Xinyuan-LilyGO/T-Display-P4-Air/firmware/[T-Display-P4-Air][nrf9151][ncs-serial-modem]/README.md

# Firmware Modification Log

## 202607141440
### Changed firmware
- `[T-Display-P4-Air][nrf9151][ncs-serial-modem_v1.0.1]_firmware_202607141440`
### Change content
- 添加 GNSS NMEA 原始数据输出指令

## 202607110924
### Changed firmware
- `[T-Display-P4-Air][nrf9151][ncs-serial-modem_v1.0.1]_firmware_202607110924.hex`
- `mfw_nrf91x1_2.0.4`
### Change content
- 初始版本
