Xinyuan-LilyGO/T-Display-P4-Air/firmware/[T-Display-P4-Air][rf_test]/README.md

# Firmware Modification Log

## 202607111723
### Changed firmware
- `[T-Display-P4-Air][rf_test]_firmware_202607111723`
### Change content
- 初始版本。
