Xinyuan-LilyGO/T-Display-P4-Air/project/T-Display-P4-Air_v1.0(Evaluation Preview)_202610161627.pdf

## C13¹uF/16V

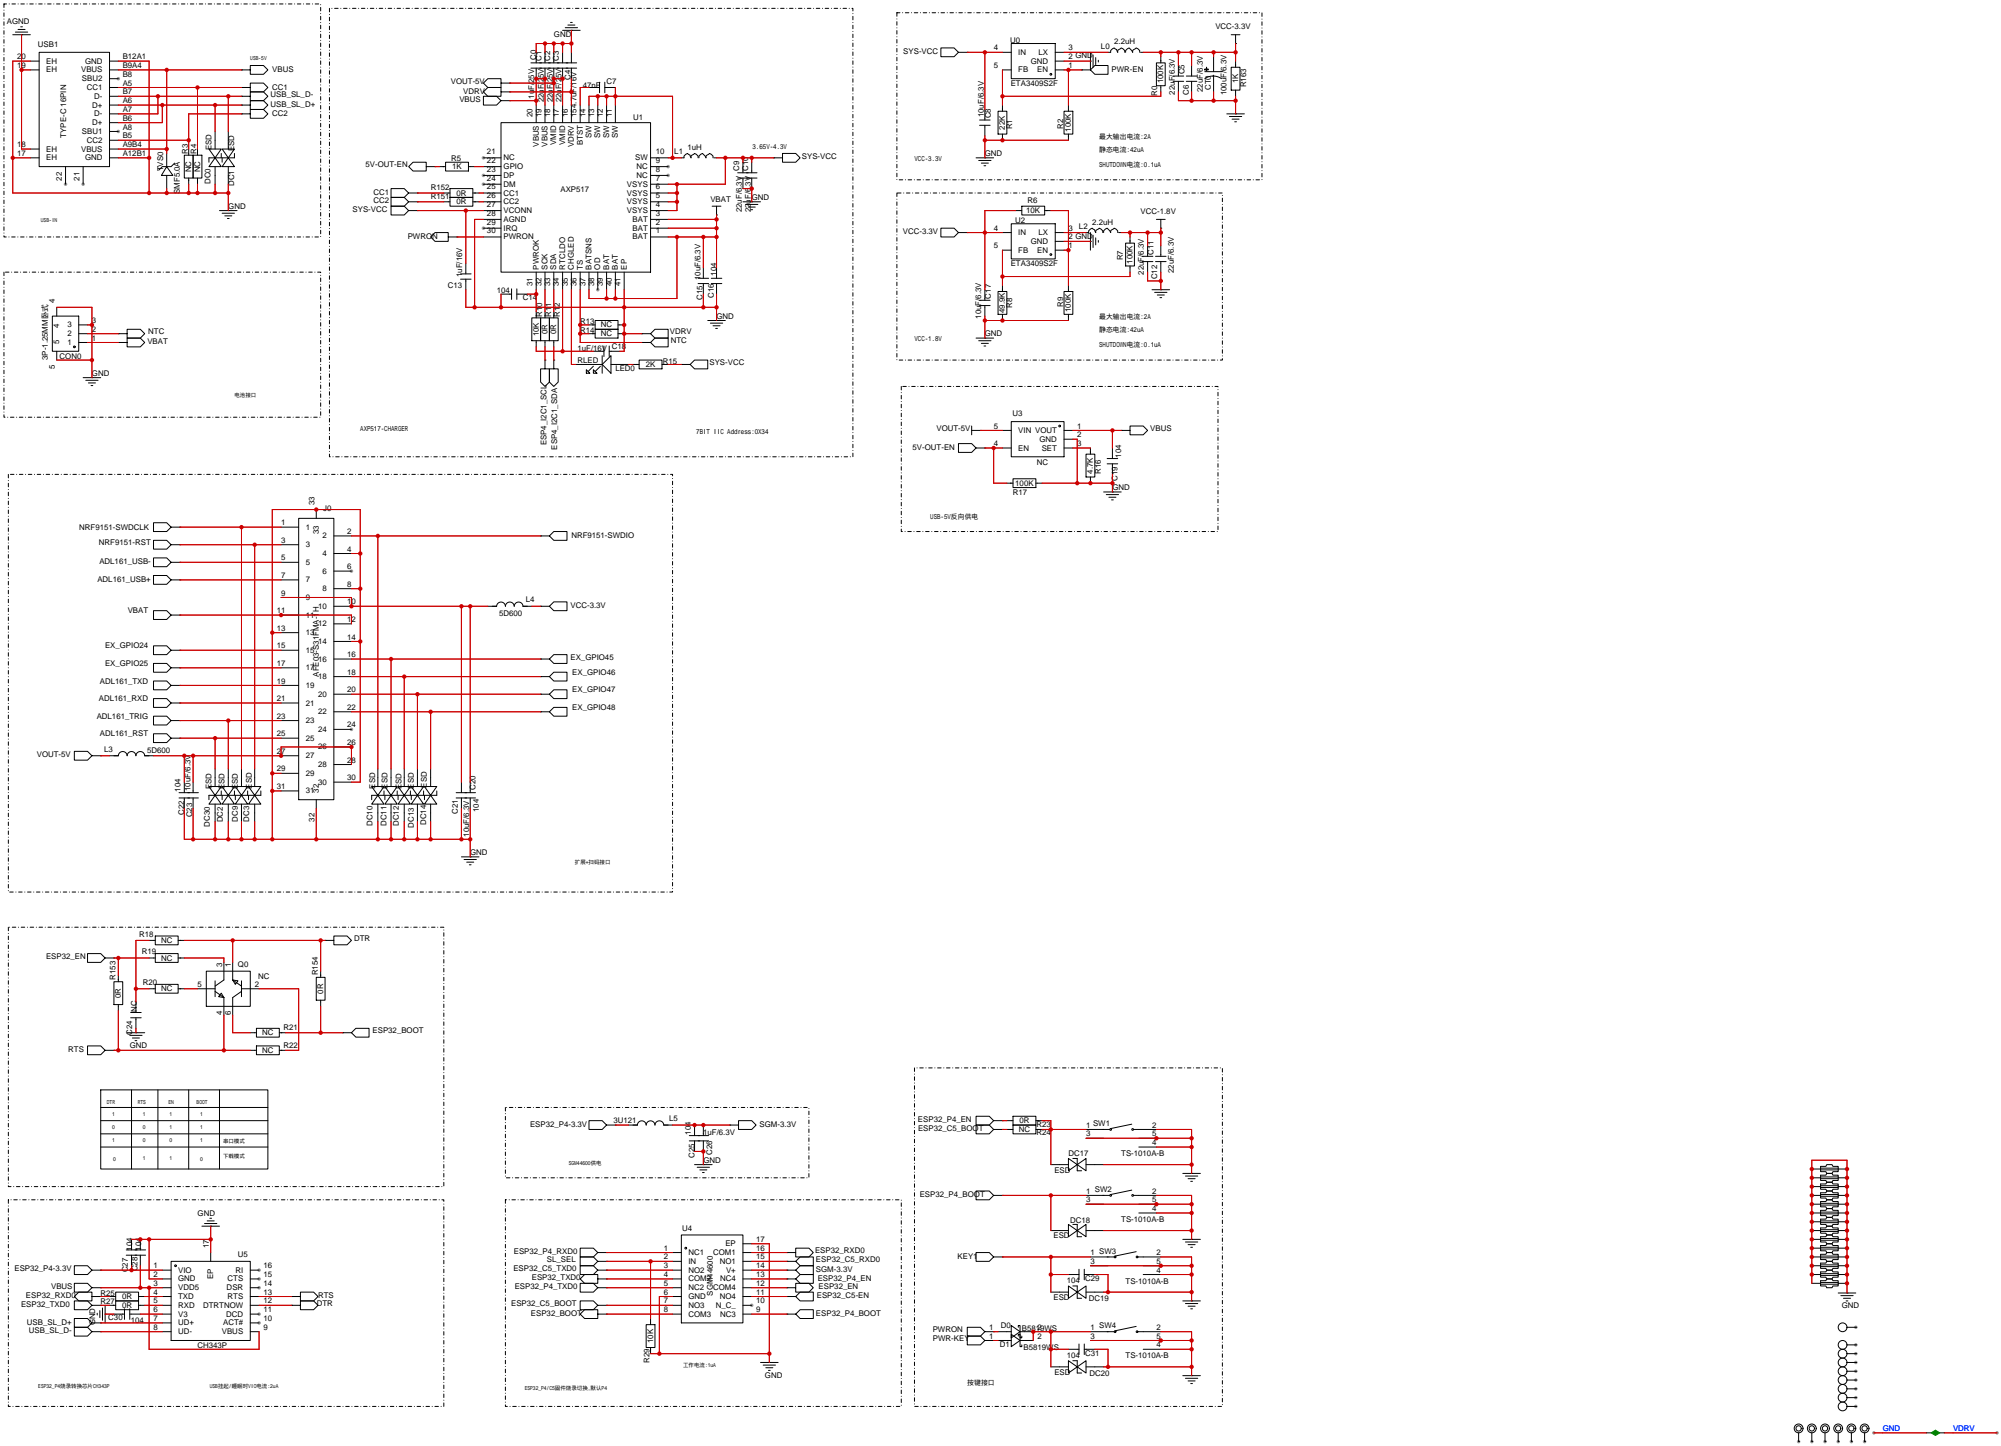
[picture p1: page 1]

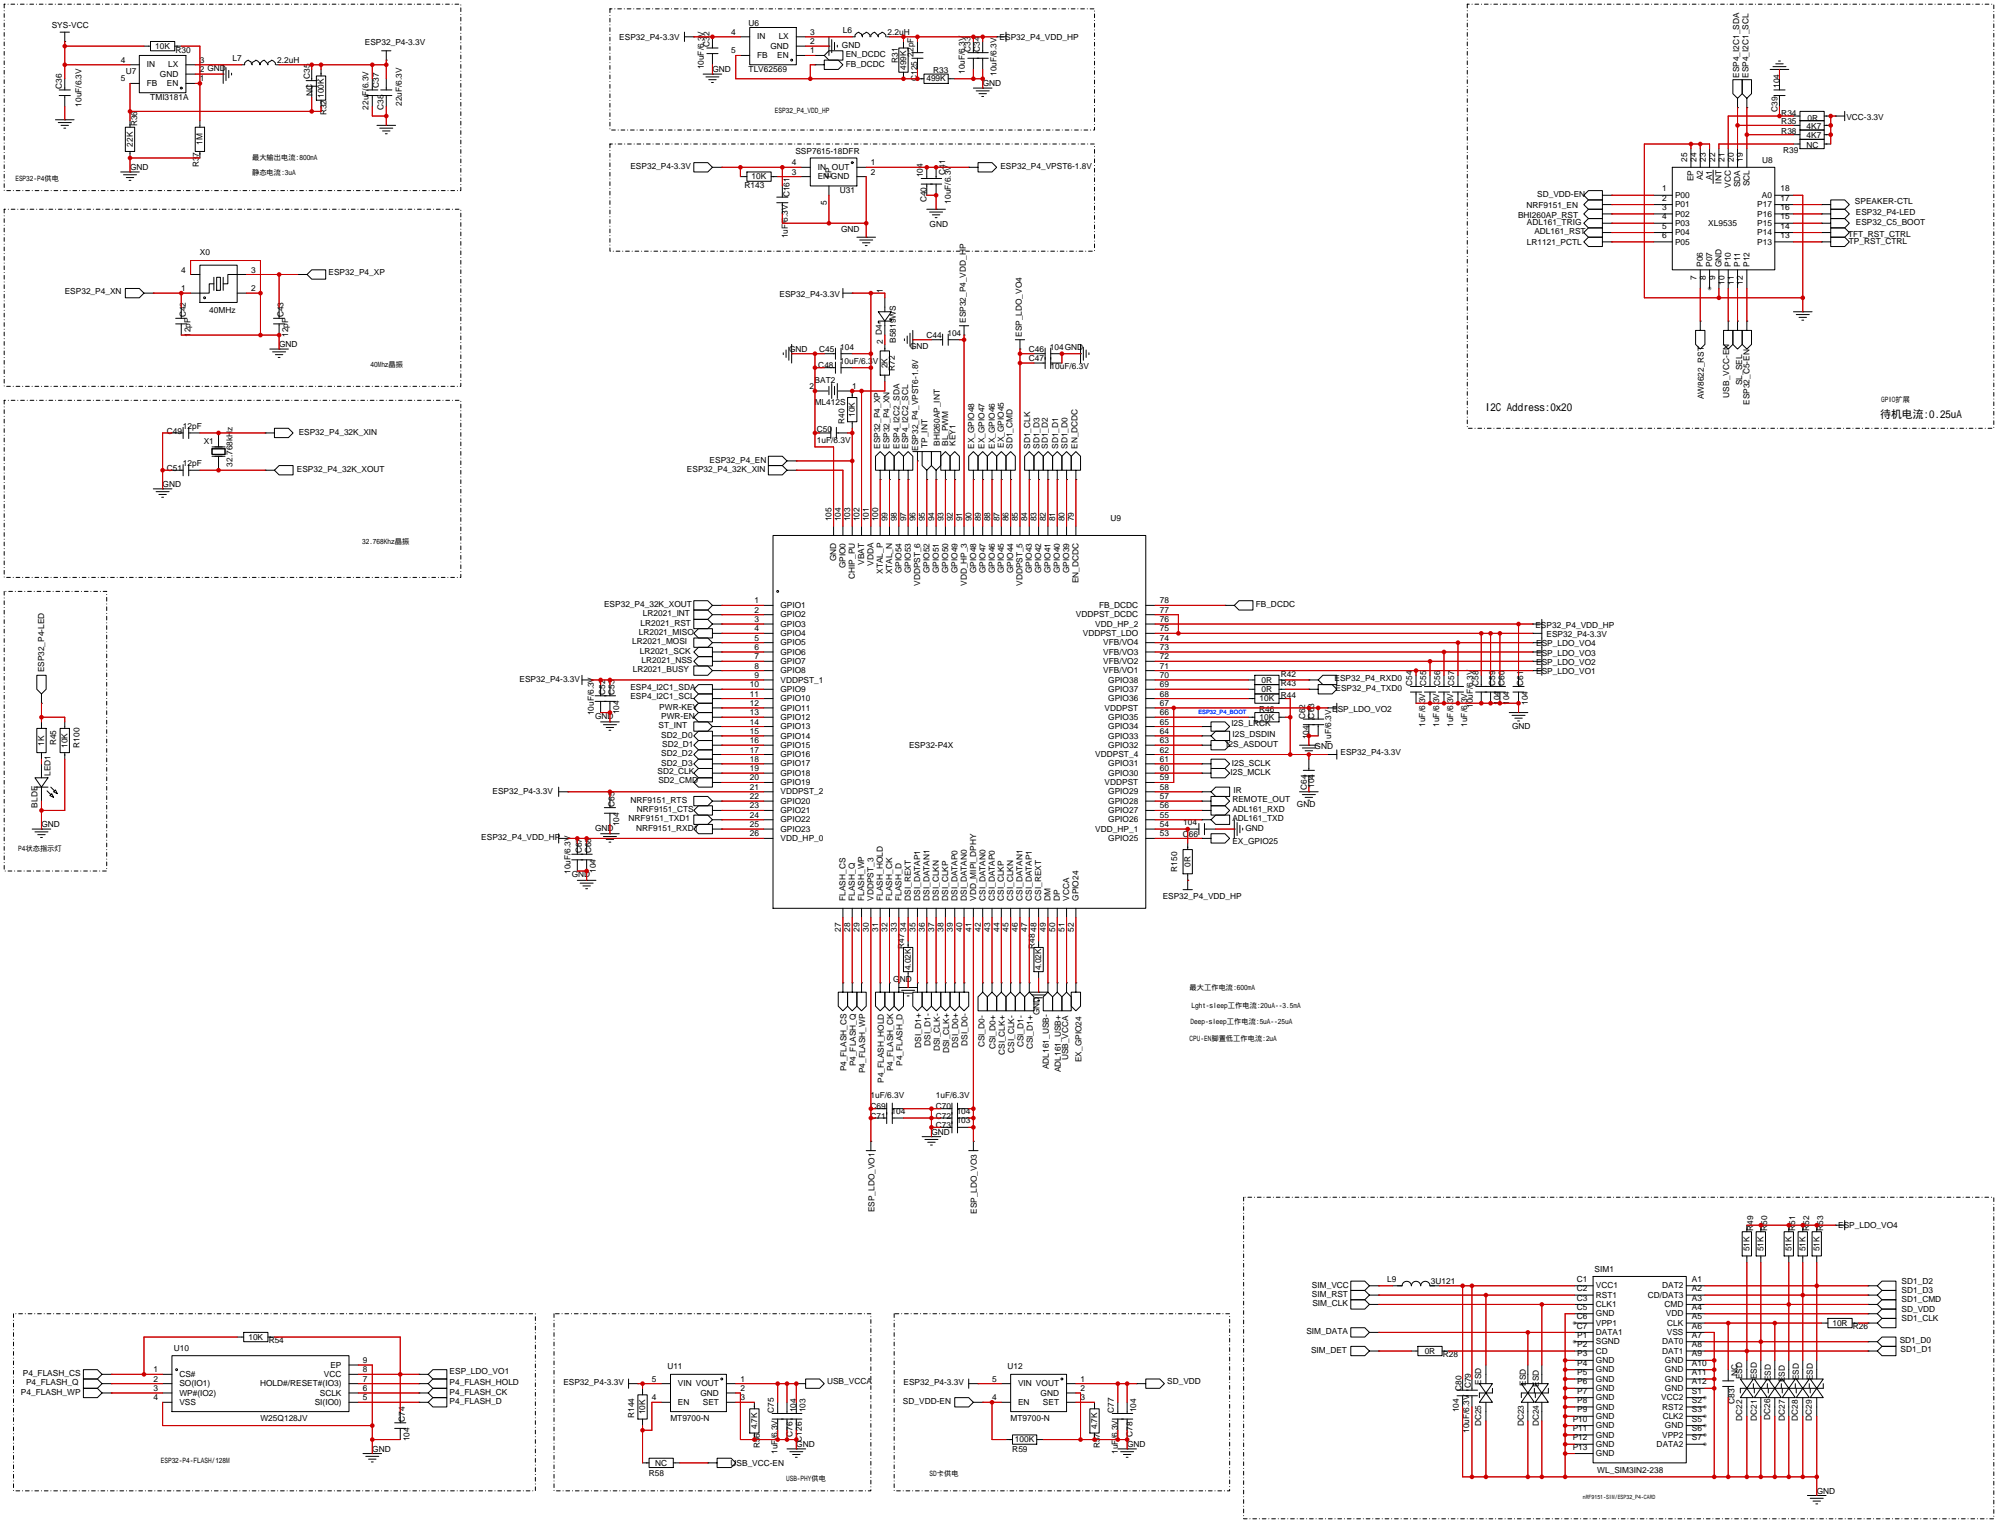
[picture p2: page 2]

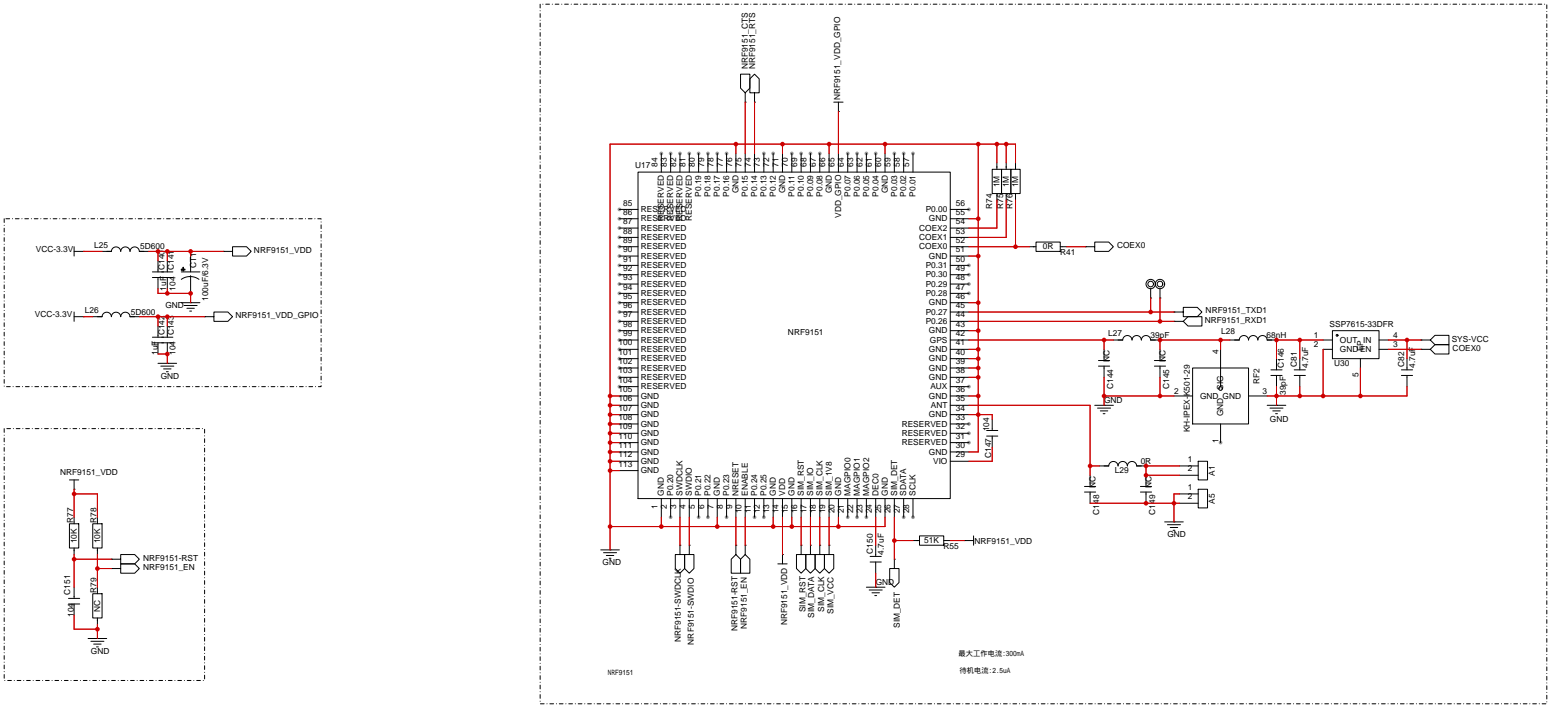
[picture p3: page 3]

L46 | 22uH | 1 D3 | B5819WS 2 C²³⁵ ¹⁰uF/6.3V

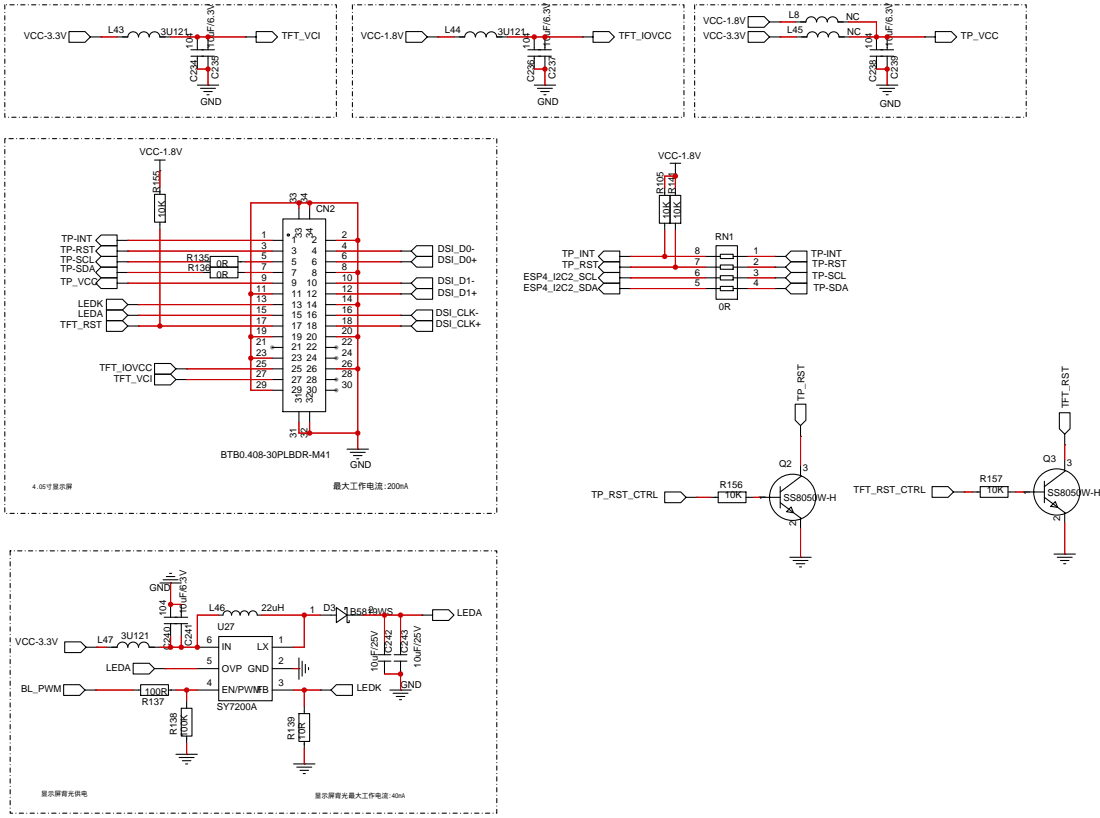
[picture p4: page 4]

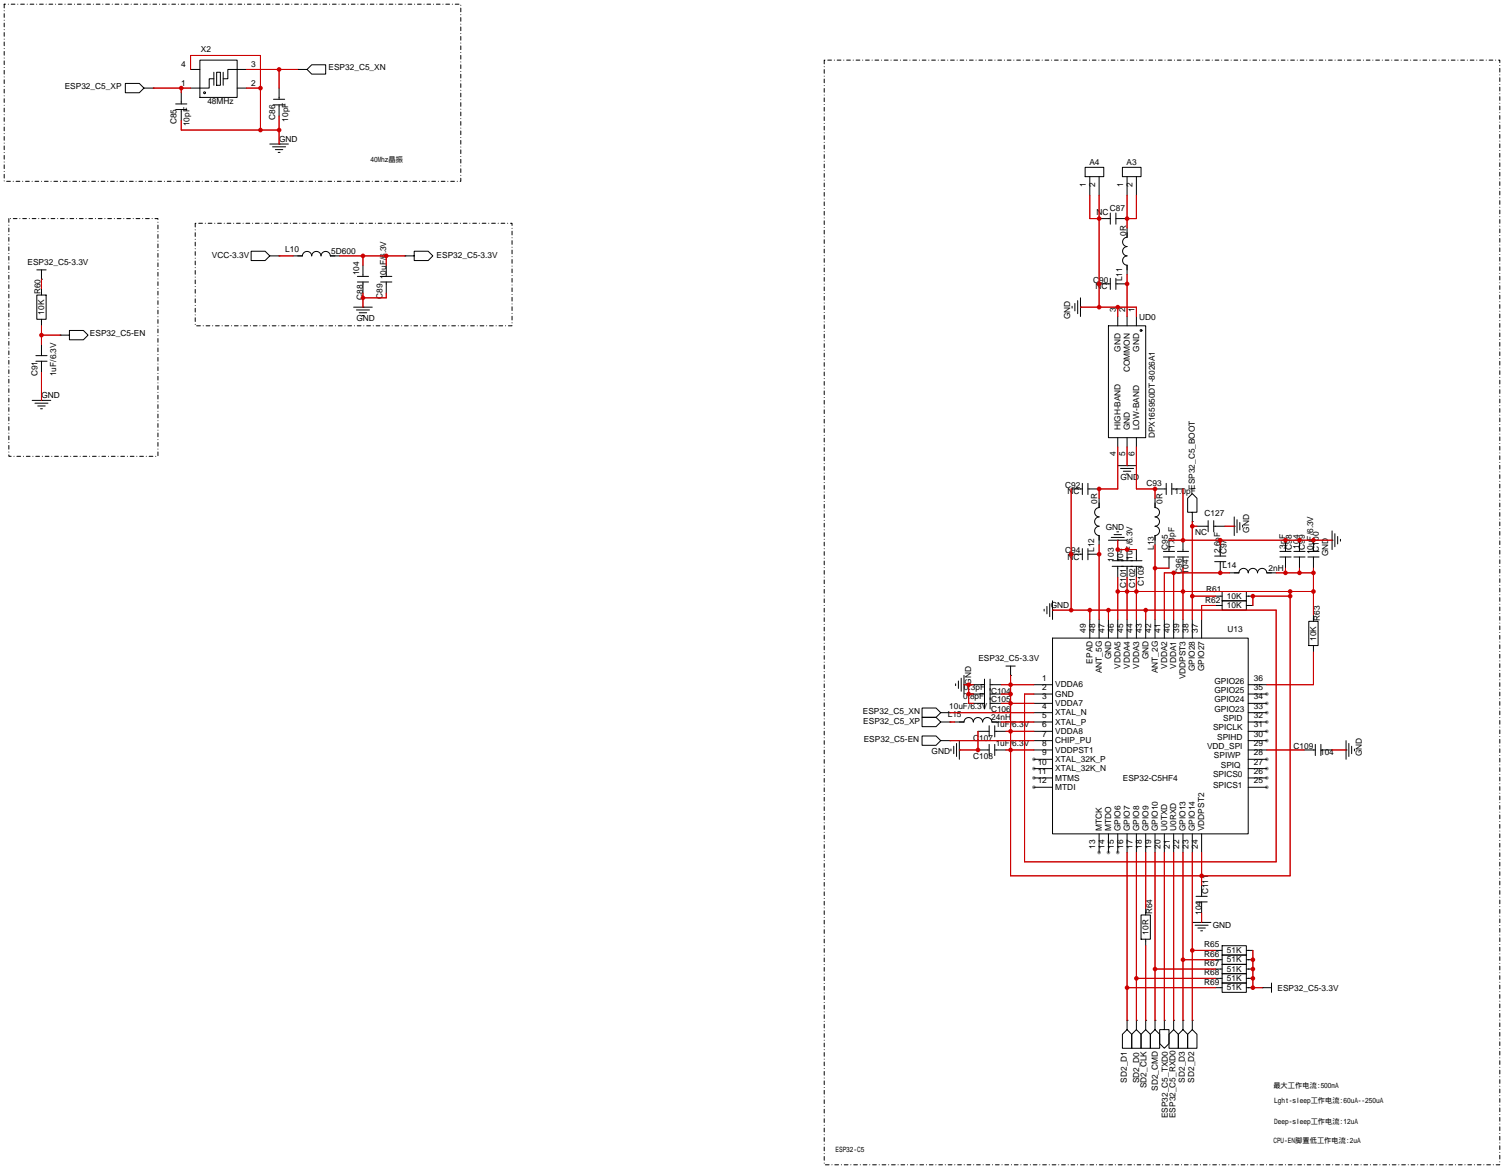
[picture p5: page 5]

GND 1 COMMON 2 GND 3 HIGH-BAND 4 GND 5 LOW-BAND 6

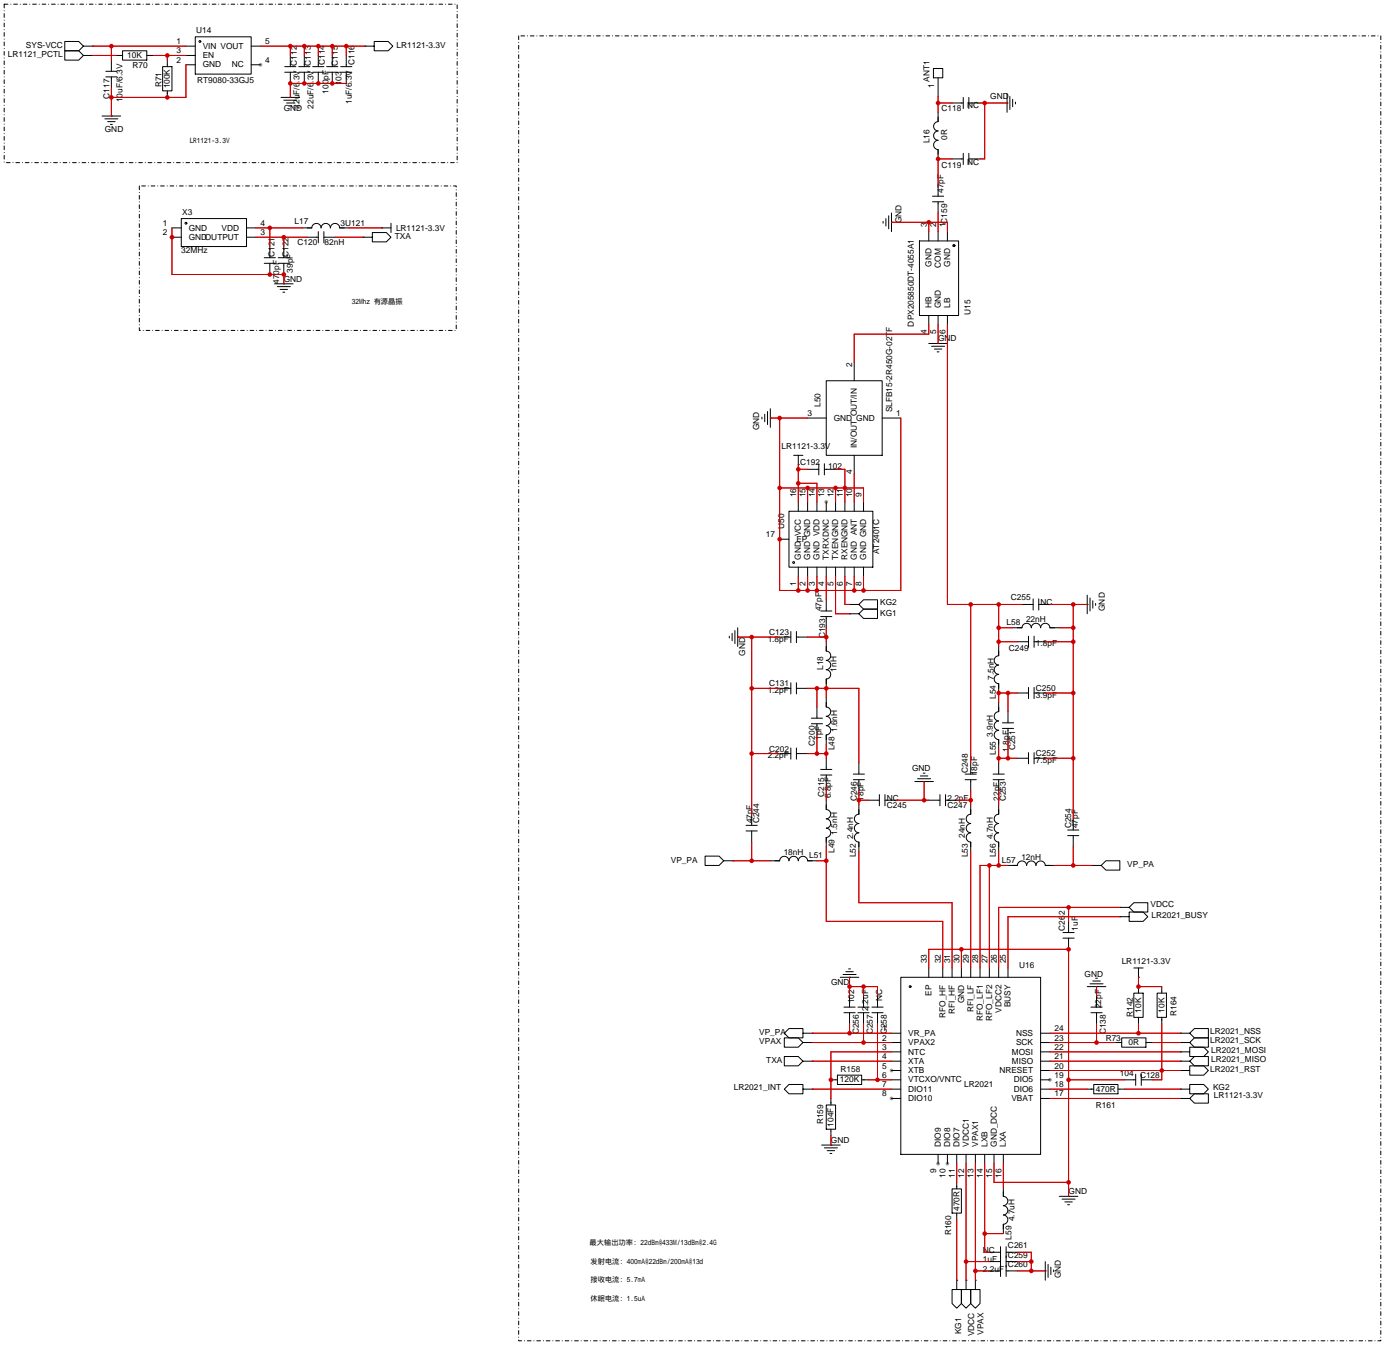
[picture p6: page 6]

9 ANT 10 GND 11 GND 12 DNC 13 VDD 14 GND 15 VCC 16

## 10KC¹⁶⁰

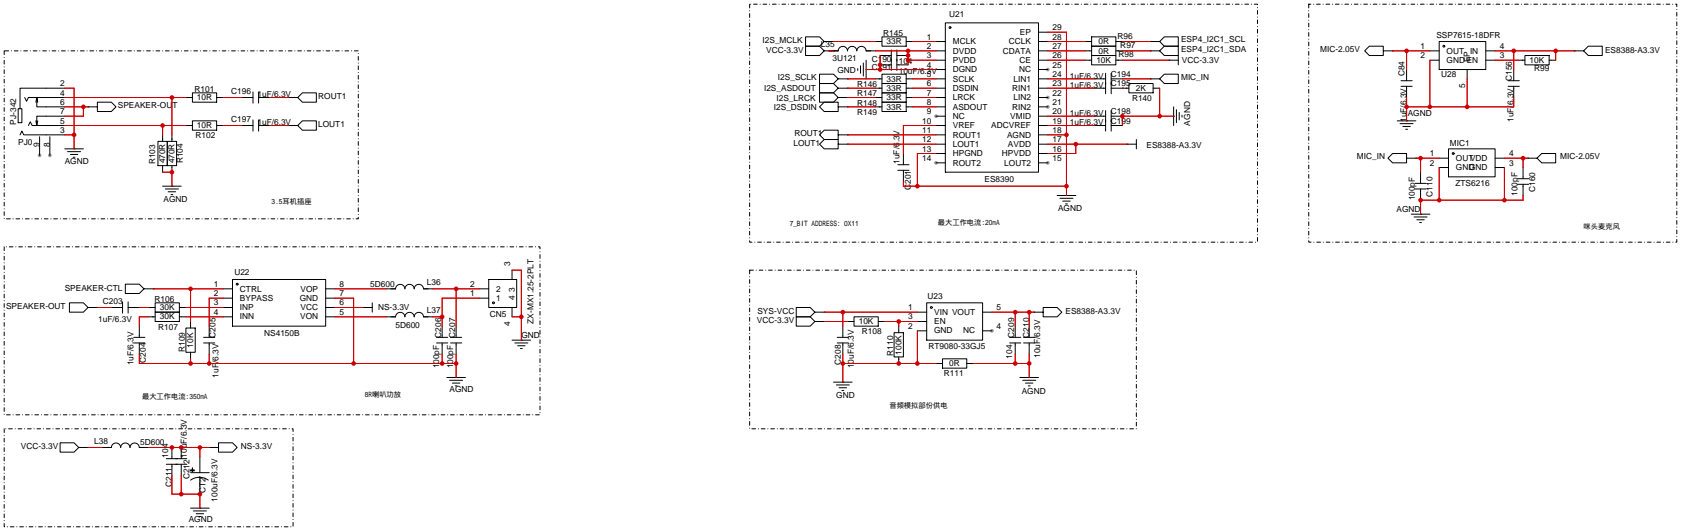
[picture p7: page 7]

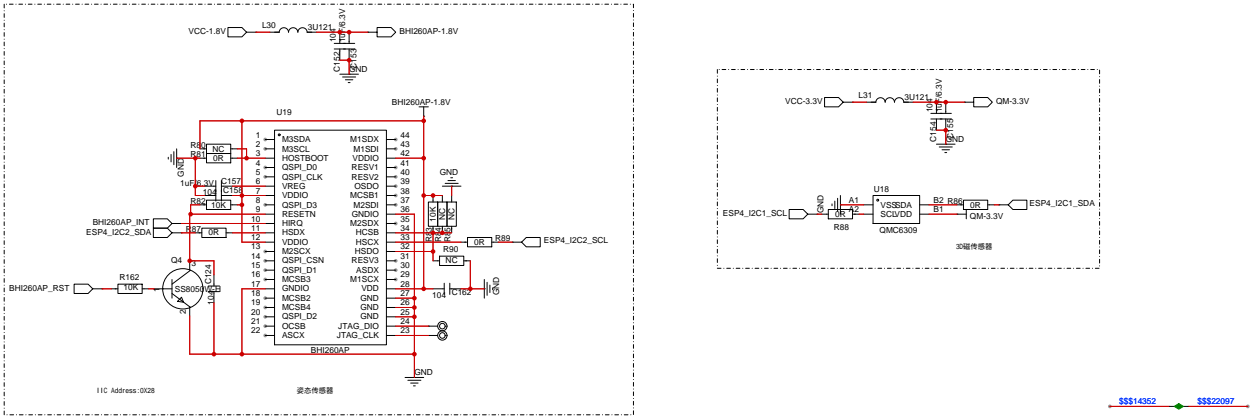
[picture p8: page 8]

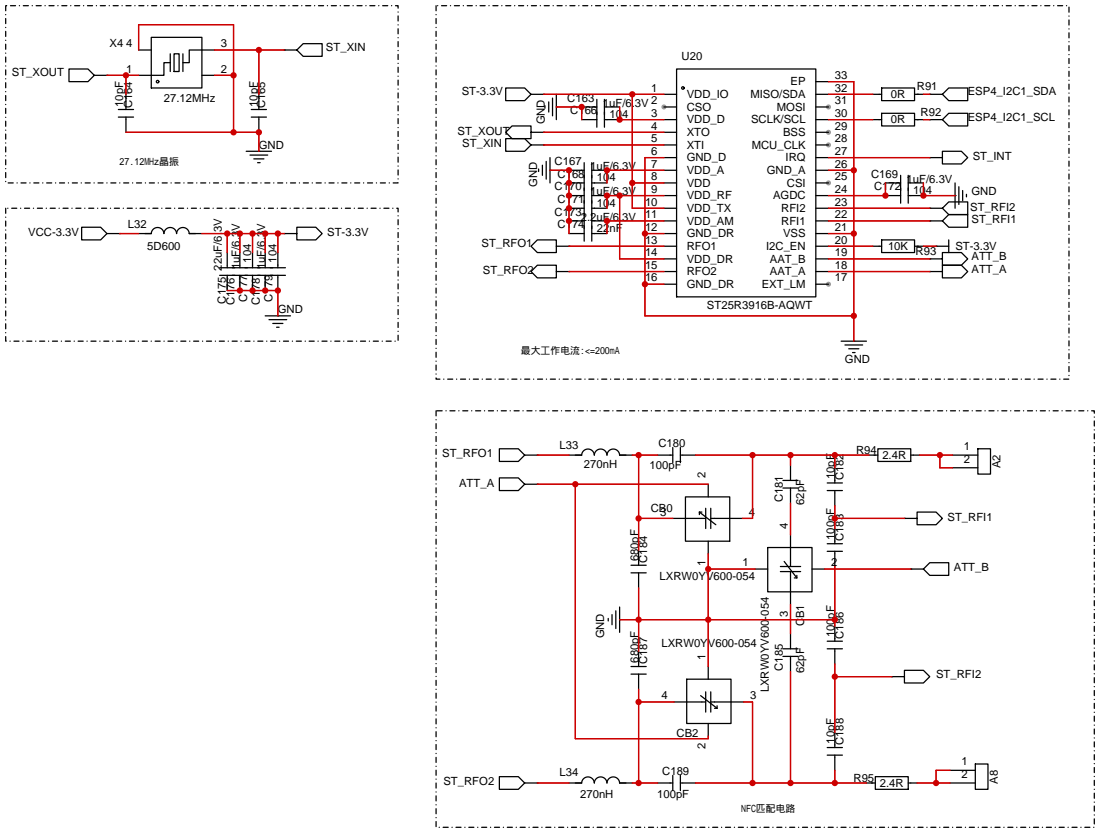
[picture p9: page 9]

C163 | 1uF/6.3V | CSO 2 VDD_D 3
C166 | | 104

VDD_TX 10
GND_DR 12

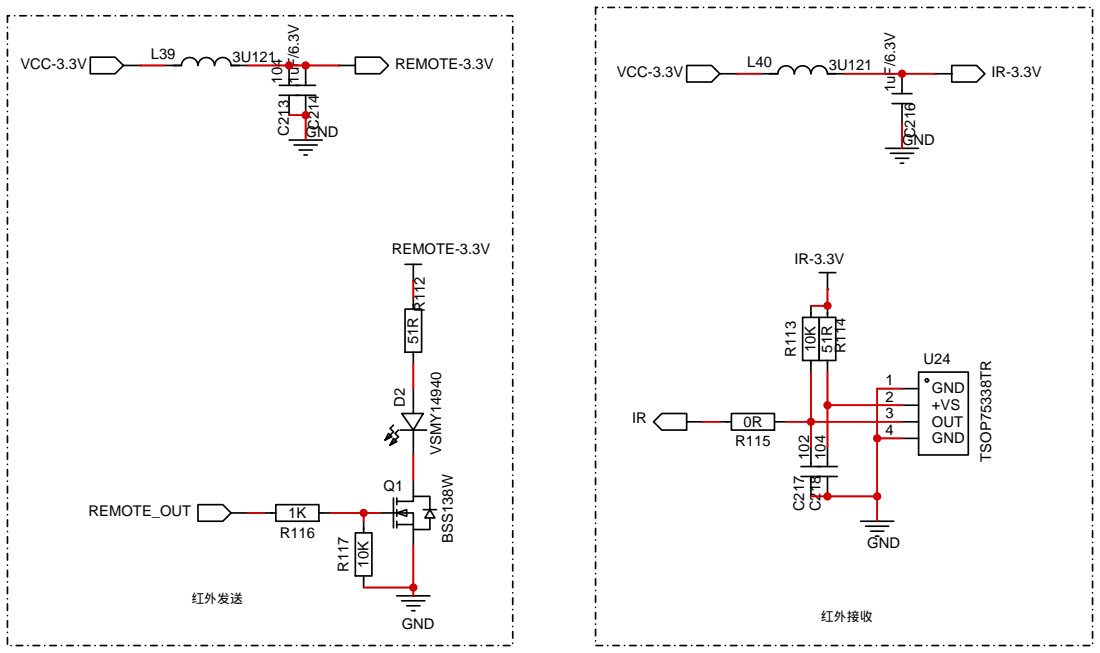
[picture p10: page 10]

# R122 NC R¹²⁵ ⁵¹K

10 | 10 11 | 11 12 | 12 13 | 13 14 | 14 15 | 15 16 | 16 17 | 17 18 | 18 19 | 19 20 | 20 21 | 21 22 | 22 23 | 23 24 | 24

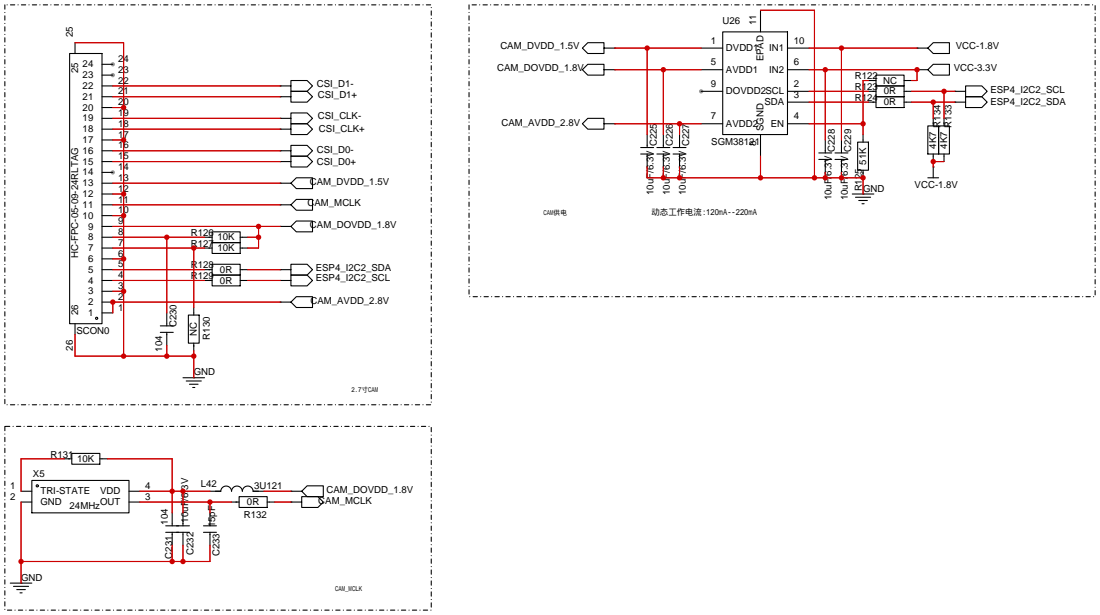
[picture p11: page 11]

SCON0 HC⁻FPC⁻⁰⁵⁻⁰⁹⁻²⁴RLTAG

# AW86224AFCRC²²⁰ ¹⁰uF/6.3V C²¹⁹ ¹⁰⁴

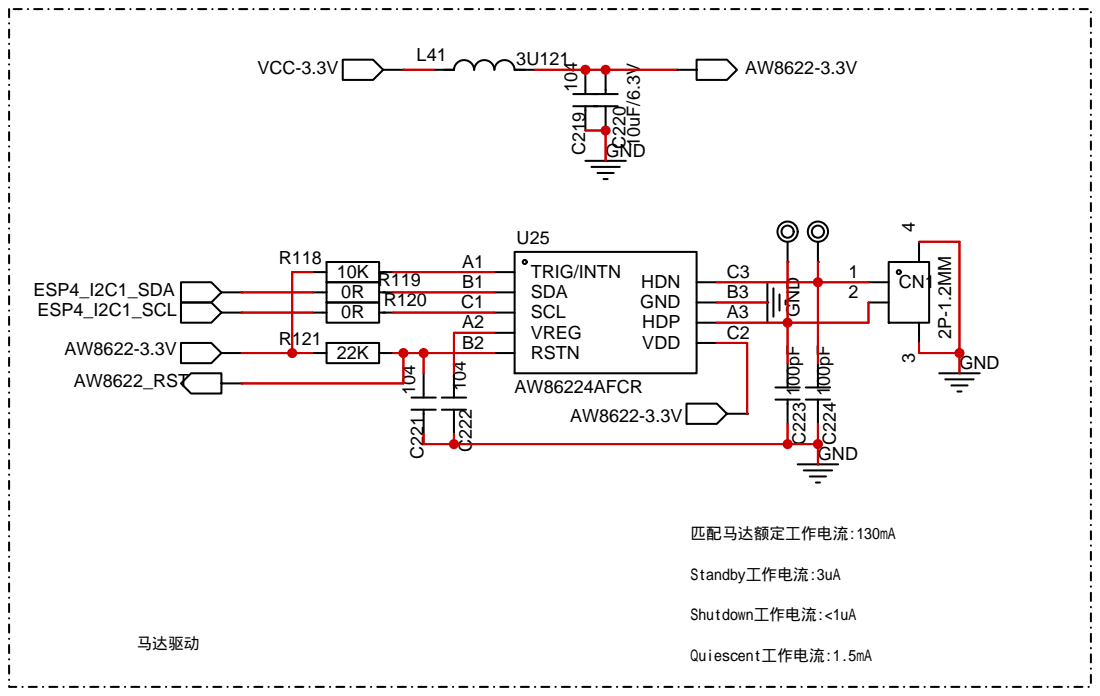
[picture p12: page 12]

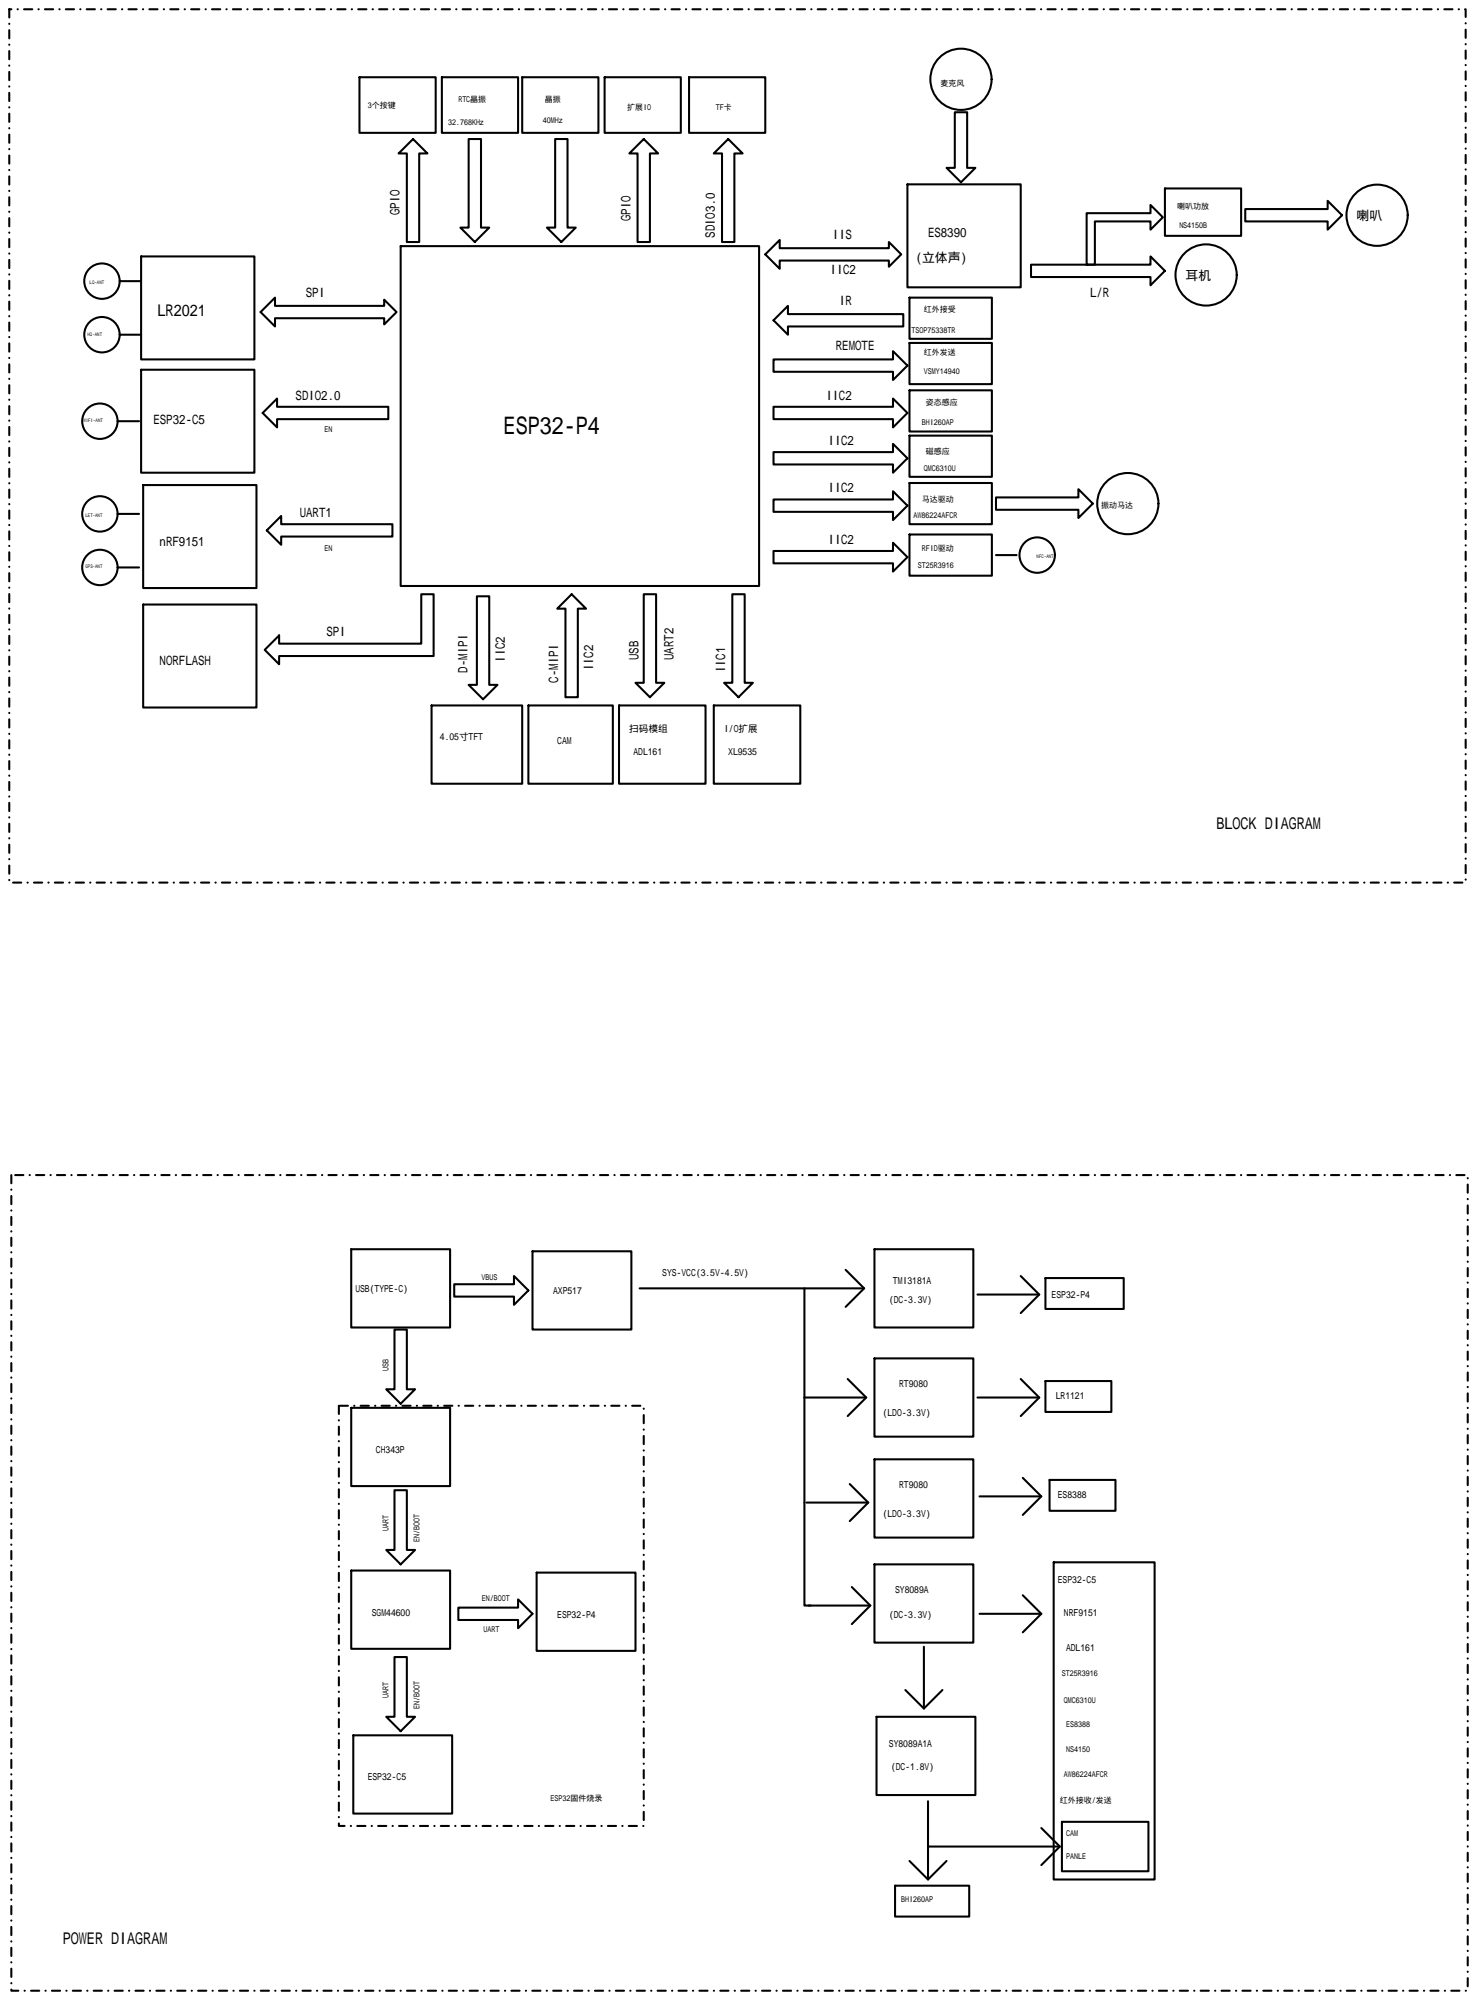
[picture p13: page 13]
