Xinyuan-LilyGO/T-Display-P4-Air/main/examples/rf_test/st25r3916_driver.h

/*
 * @Description: None
 * @Author: LILYGO_L
 * @Date: 2025-08-09 11:13:53
 * @LastEditTime: 2025-09-05 14:38:18
 * @License: GPL 3.0
 */
#pragma once
#include "rfal_rfst25r3916.h"

void St25r3916_Init(void);
void St25r3916_Loop(void);

#ifdef ERR_TIMEOUT
#undef ERR_TIMEOUT
#endif

extern RfalRfST25R3916Class rfst25r3916;
