Xinyuan-LilyGO/T-Display-P4-Air/main/examples/iperf/main.cpp

/*
 * @Description: None
 * @Author: LILYGO_L
 * @Date: 2026-02-09 14:35:28
 * @LastEditTime: 2026-06-18 15:43:03
 * @License: GPL 3.0
 */
#include "lilygo_device_driver.h"

#include <errno.h>
#include <string.h>
#include <cstdio>
#include "esp_wifi.h"
#include "esp_log.h"
#include "esp_err.h"
#include "esp_hosted.h"
#include "esp_hosted_transport_config.h"
#include "nvs_flash.h"
#include "esp_console.h"
#include "cmd_system.h"

/* component manager */
#include "iperf.h"
#include "wifi_cmd.h"
#include "iperf_cmd.h"
#include "ping_cmd.h"

#if CONFIG_ESP_WIFI_ENABLE_WIFI_TX_STATS || CONFIG_ESP_WIFI_ENABLE_WIFI_RX_STATS
#include "esp_wifi_he.h"
#endif
#if CONFIG_ESP_WIFI_ENABLE_WIFI_TX_STATS
extern int wifi_cmd_get_tx_statistics(int argc, char **argv);
extern int wifi_cmd_clr_tx_statistics(int argc, char **argv);
#endif
#if CONFIG_ESP_WIFI_ENABLE_WIFI_RX_STATS
extern int wifi_cmd_get_rx_statistics(int argc, char **argv);
extern int wifi_cmd_clr_rx_statistics(int argc, char **argv);
#endif

#if defined(CONFIG_ESP_EXT_CONN_ENABLE) && defined(CONFIG_ESP_HOST_WIFI_ENABLED)
#include "esp_extconn.h"
#endif

namespace {

esp_err_t SetEsp32c5ResetLevel(void* context, bool level) {
    auto* driver = static_cast<
        lilygo_device_driver::TDisplayP4AirDriver*>(context);
    return driver != nullptr && driver->SetEsp32c5PowerEnabled(level)
        ? ESP_OK
        : ESP_FAIL;
}

bool RegisterEsp32c5ResetCallback(
    lilygo_device_driver::TDisplayP4AirDriver* driver) {
    return esp_hosted_sdio_set_reset_callback(
               SetEsp32c5ResetLevel, driver) == ESP_TRANSPORT_OK;
}

}  // namespace

void iperf_hook_show_wifi_stats(iperf_traffic_type_t type, iperf_status_t status)
{
    if (status == IPERF_STARTED)
    {
#if CONFIG_ESP_WIFI_ENABLE_WIFI_TX_STATS
        if (type != IPERF_UDP_SERVER)
        {
            wifi_cmd_clr_tx_statistics(0, NULL);
        }
#endif
#if CONFIG_ESP_WIFI_ENABLE_WIFI_RX_STATS
        if (type != IPERF_UDP_CLIENT)
        {
            wifi_cmd_clr_rx_statistics(0, NULL);
        }
#endif
    }

    if (status == IPERF_STOPPED)
    {
#if CONFIG_ESP_WIFI_ENABLE_WIFI_TX_STATS
        if (type != IPERF_UDP_SERVER)
        {
            wifi_cmd_get_tx_statistics(0, NULL);
        }
#endif
#if CONFIG_ESP_WIFI_ENABLE_WIFI_RX_STATS
        if (type != IPERF_UDP_CLIENT)
        {
            wifi_cmd_get_rx_statistics(0, NULL);
        }
#endif
    }
}

extern "C" void app_main(void)
{
    printf("Ciallo\n");

    auto& driver = lilygo_device_driver::TDisplayP4AirDriver::GetInstance();
    if (!driver.InitMinimal() || !driver.InitXl9535())
    {
        printf("ESP32-C5 control hardware initialization failed\n");
        return;
    }
    if (!driver.SetEsp32c5PowerEnabled(true))
    {
        printf("ESP32-C5 power enable failed\n");
        return;
    }
    if (!RegisterEsp32c5ResetCallback(&driver))
    {
        printf("Register ESP32-C5 reset callback failed\n");
        return;
    }
    const esp_err_t hosted_result = esp_hosted_init();
    if (hosted_result != ESP_OK)
    {
        printf("esp_hosted_init failed: %s\n", esp_err_to_name(hosted_result));
        return;
    }

#if defined(CONFIG_ESP_EXT_CONN_ENABLE) && defined(CONFIG_ESP_HOST_WIFI_ENABLED)
    esp_extconn_config_t ext_config = ESP_EXTCONN_CONFIG_DEFAULT();
    esp_extconn_init(&ext_config);
#endif

    esp_err_t ret = nvs_flash_init();
    if (ret == ESP_ERR_NVS_NO_FREE_PAGES || ret == ESP_ERR_NVS_NEW_VERSION_FOUND)
    {
        ESP_ERROR_CHECK(nvs_flash_erase());
        ret = nvs_flash_init();
    }
    ESP_ERROR_CHECK(ret);

    /*
    NOTE(#15855): wifi_cmd_initialize_wifi is a basic function to start wifi, set handlers and set wifi-cmd status.
    For advanced usage, please refer to wifi_cmd.h or the document of wifi-cmd component: https://components.espressif.com/components/esp-qa/wifi-cmd

    example:
        wifi_cmd_wifi_init();
        my_function();  // <---- more configs before wifi start
        wifi_cmd_wifi_start();

    Please note that some wifi commands such as "wifi start/restart" may not work as expected if "wifi_cmd_initialize_wifi" was not used.
    */
    /* initialise wifi and set wifi-cmd status */
    wifi_cmd_initialize_wifi(NULL);
    ESP_ERROR_CHECK(esp_wifi_set_ps(WIFI_PS_NONE));

#if CONFIG_ESP_WIFI_ENABLE_WIFI_RX_STATS
#if CONFIG_ESP_WIFI_ENABLE_WIFI_RX_MU_STATS
    esp_wifi_enable_rx_statistics(true, true);
#else
    esp_wifi_enable_rx_statistics(true, false);
#endif
#endif
#if CONFIG_ESP_WIFI_ENABLE_WIFI_TX_STATS
    esp_wifi_enable_tx_statistics(ESP_WIFI_ACI_BE, true);
#endif

    esp_console_repl_t *repl = NULL;
    esp_console_repl_config_t repl_config = ESP_CONSOLE_REPL_CONFIG_DEFAULT();
    repl_config.prompt = "iperf>";

    // init console REPL environment
#if CONFIG_ESP_CONSOLE_UART
    esp_console_dev_uart_config_t uart_config = ESP_CONSOLE_DEV_UART_CONFIG_DEFAULT();
    ESP_ERROR_CHECK(esp_console_new_repl_uart(&uart_config, &repl_config, &repl));
#elif CONFIG_ESP_CONSOLE_USB_CDC
    esp_console_dev_usb_cdc_config_t cdc_config = ESP_CONSOLE_DEV_CDC_CONFIG_DEFAULT();
    ESP_ERROR_CHECK(esp_console_new_repl_usb_cdc(&cdc_config, &repl_config, &repl));
#elif CONFIG_ESP_CONSOLE_USB_SERIAL_JTAG
    esp_console_dev_usb_serial_jtag_config_t usbjtag_config = ESP_CONSOLE_DEV_USB_SERIAL_JTAG_CONFIG_DEFAULT();
    ESP_ERROR_CHECK(esp_console_new_repl_usb_serial_jtag(&usbjtag_config, &repl_config, &repl));
#endif

    /* Register commands */
    register_system();
    /* From wifi-cmd */
    wifi_cmd_register_all();
    /* From iperf-cmd */
    app_register_iperf_commands();
    app_register_iperf_hook_func(iperf_hook_show_wifi_stats);
    /* From ping-cmd */
    ping_cmd_register_ping();

    printf("\n ==================================================\n");
    printf(" |       Steps to test WiFi throughput            |\n");
    printf(" |                                                |\n");
    printf(" |  1. Print 'help' to gain overview of commands  |\n");
    printf(" |  2. Configure device to station or soft-AP     |\n");
    printf(" |  3. Setup WiFi connection                      |\n");
    printf(" |  4. Run iperf to test UDP/TCP RX/TX throughput |\n");
    printf(" |                                                |\n");
    printf(" =================================================\n\n");

    // start console REPL
    ESP_ERROR_CHECK(esp_console_start_repl(repl));
}
