Xinyuan-LilyGO/T-Display-P4-Air/(commit log)

2026-02-09 modify the input voltage limit of the axp517 to 4.7v to fix the abnormal charging indicator issue in the default state
2026-02-28 update camera
2026-03-12 update [T-Display-P4-Air][esp32c5][esp32c5_slave_esp_hosted_mcu_network_adapter_v2.11.5][sdio]_firmware_202602091347
2026-08-19 feat(examples): align with updated drivers and local ESP-Hosted
    - Migrate examples to minimal initialization and initialize peripherals on demand.
    - Update nRF9151, LR1121, ST25R3916, and infrared examples for the latest driver APIs.
    - Add external ESP32-C5 reset handling before manual ESP-Hosted initialization.
    - Rename the local ESP-Hosted component directory to libraries/esp_hosted.
    - Use the local ESP-Hosted component and disable automatic initialization.
    - Remove obsolete LVGL, camera, IPA, and SPIFFS partition configurations.
2026-09-05 fix(examples): adapt to updated driver APIs
    - Update public driver headers
    - Replace legacy GPIO helpers with PlatformHal
    - Add explicit includes and component dependencies
    - Handle button GPIO initialization failures
2026-10-17 docs: add Air project documentation and v1.0 evaluation schematic
    - Add English and Chinese project documentation
    - Document hardware modules and both display options
    - Add ESP-IDF setup, example links, pin configuration, and FAQ
    - Include the v1.0 Evaluation Preview schematic
    - Document release status and evaluation hardware notes
2026-10-17 docs: fix Air pin configuration links in both READMEs
    - Replace relative submodule paths with direct GitHub links to the Air board configuration
2026-10-19 docs: correct NFC interface and magnetic sensor model
    - Change ST25R3916B interface from SPI to I2C
    - Update magnetic sensor model to QMC6309
